burden-bear/Braille-Evalutation-Board/README.md

# Braille-Evalutation-Board
Adapted from https://hackaday.io/project/191181-electromechanical-refreshable-braille-module
