burden-bear/Braille-Evalutation-Board/braille-6/Braille Evaluation Board.kicad_pcb

## KiCad design braille-6/Braille Evaluation Board.kicad_pcb (2025-08-07)

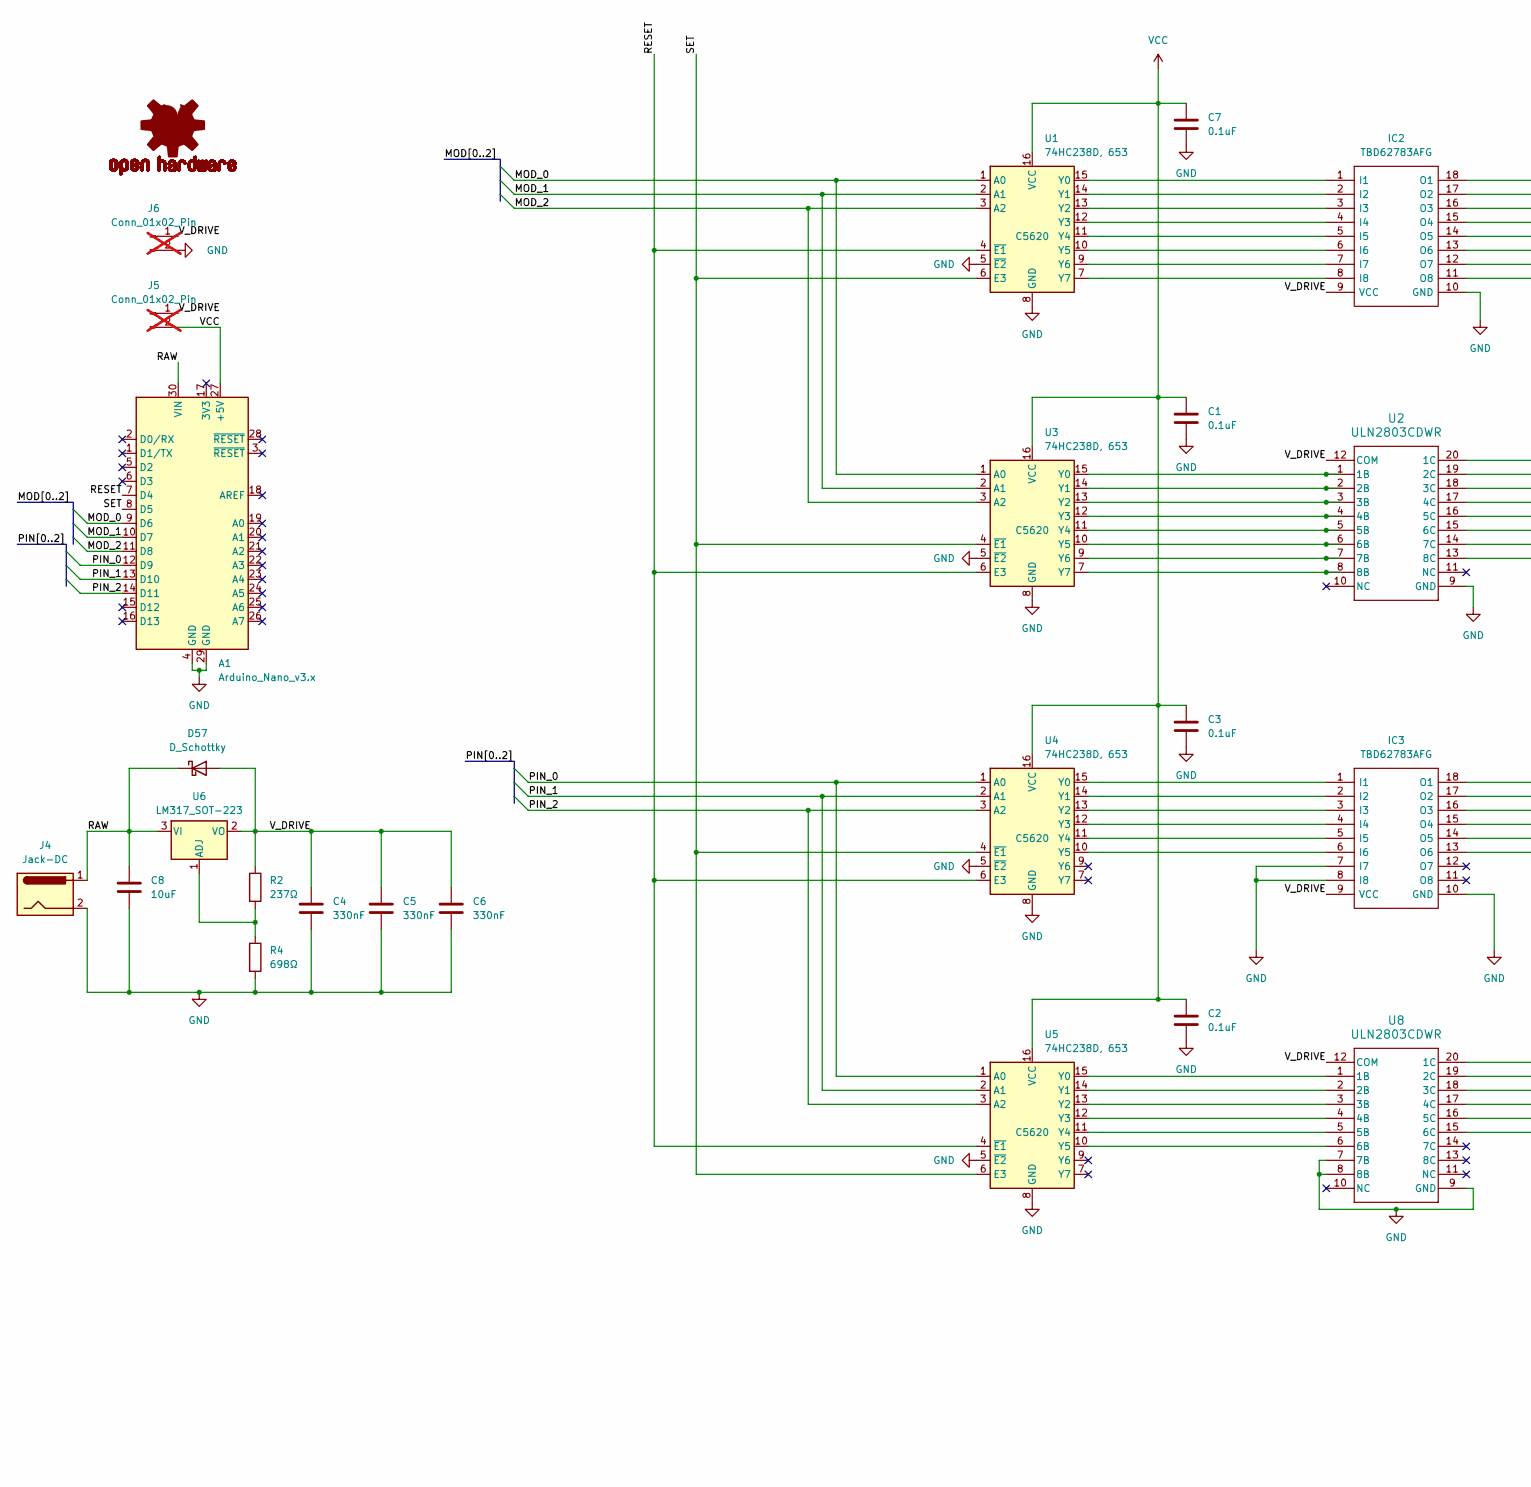
[picture p1: schematic Braille Evaluation Board.kicad_sch, part in row 1, column 1]

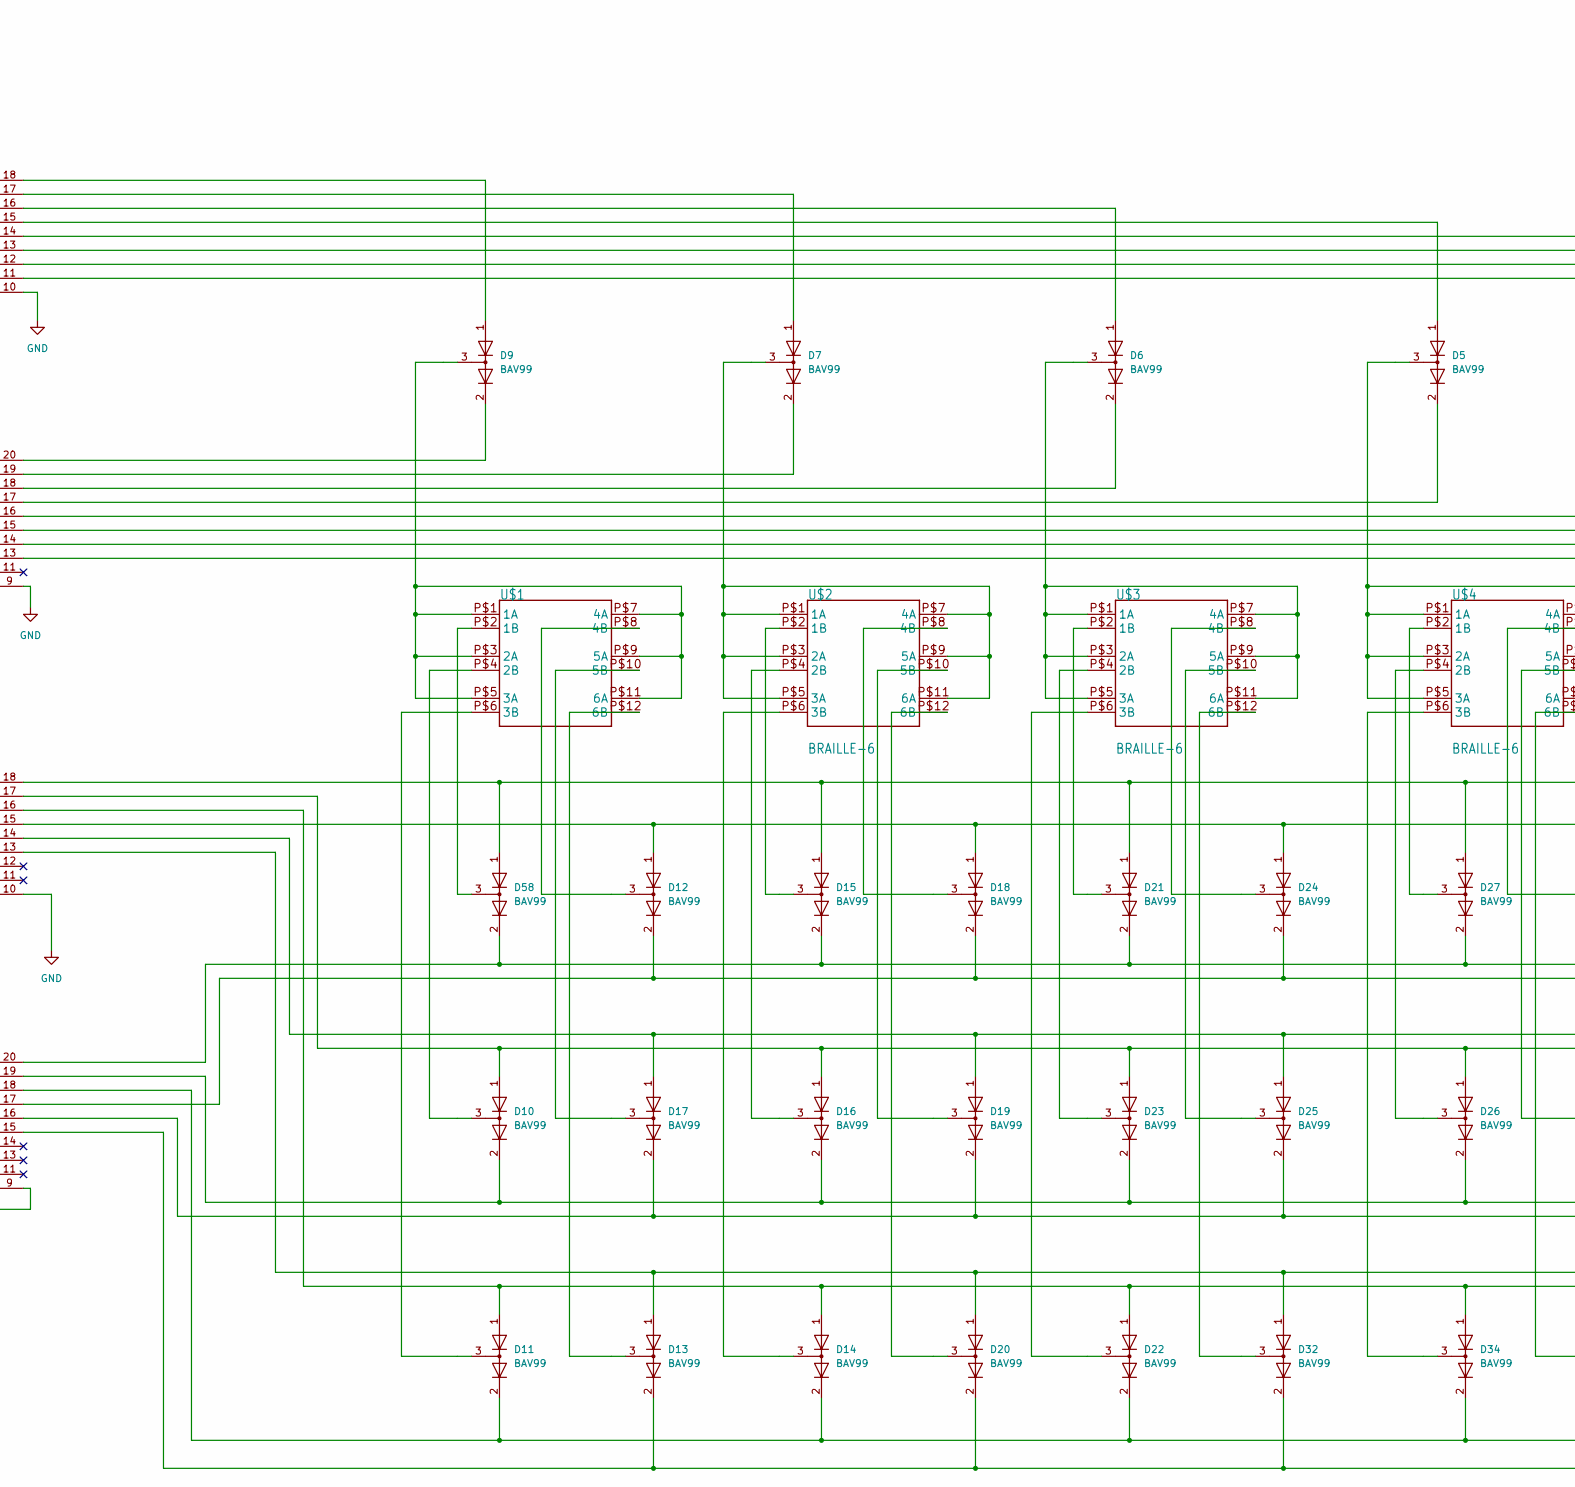
[picture p2: schematic Braille Evaluation Board.kicad_sch, part in row 1, column 2]

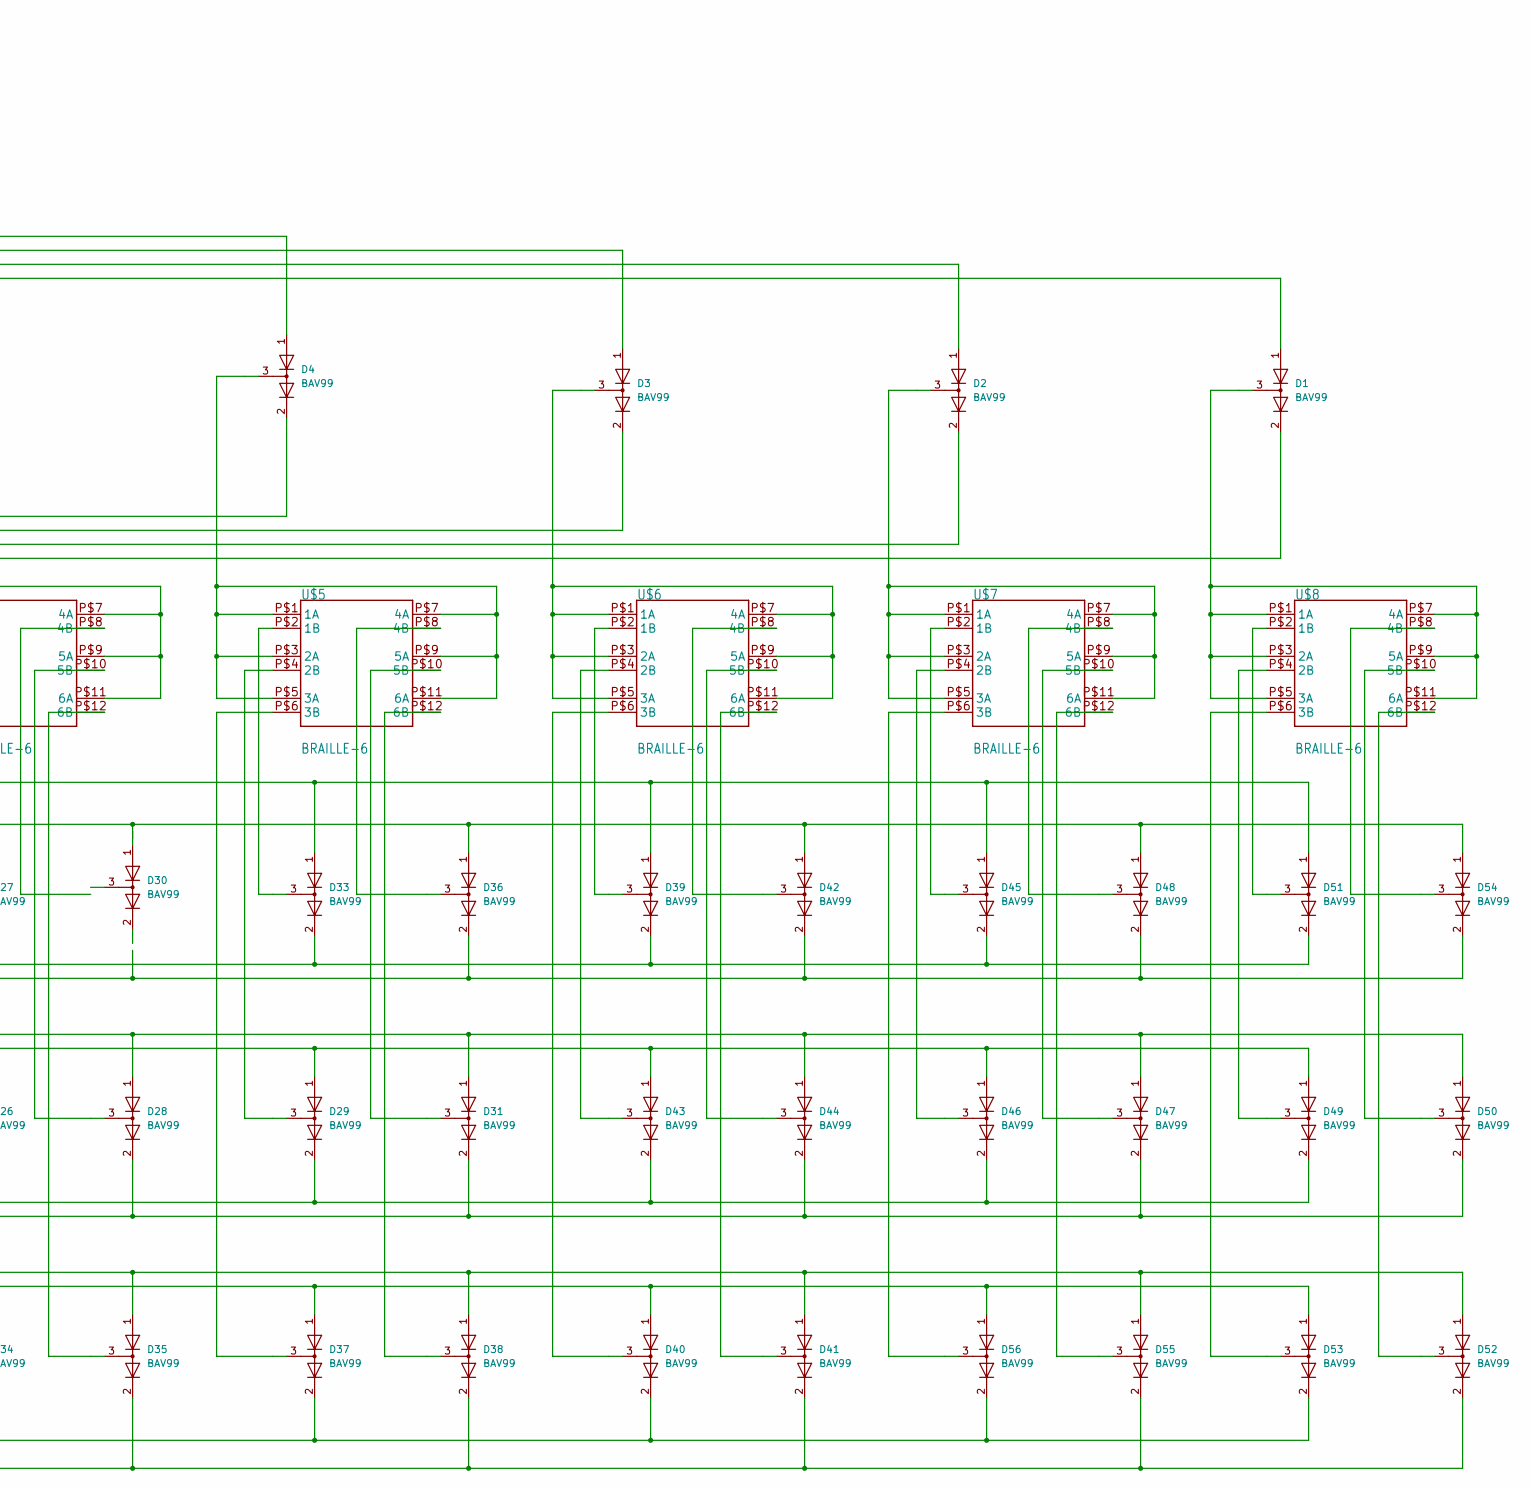
[picture p3: schematic Braille Evaluation Board.kicad_sch, part in row 1, column 3]

Parts:
A1: Arduino_Nano_v3.x; Arduino_Nano
C1, C2, C3, C7: 0.1uF; C_0402_1005Metric; LCSC Part # C71629
C4, C5, C6: 330nF; C_0402_1005Metric; LCSC Part # C913655
C8: 10uF; C_0603_1608Metric; LCSC Part # C92487
D1, D2, D3, D4, D5, D6, D7, D9, D10, D11, D12, D13, D14, D15, D16, D17, D18, D19, D20, D21, D22, D23, D24, D25, D26, D27, D28, D29, D30, D31, D32, D33, D34, D35, D36, D37, D38, D39, D40, D41, D42, D43, D44, D45, D46, D47, D48, D49, D50, D51, D52, D53, D54, D55, D56, D58: BAV99; SOT-23-3; LCSC Part # C7420336
D57: D_Schottky; D_SOD-323; LCSC Part # C177096
IC2, IC3: TBD62783AFG; SOIC-18W_7.5x11.6mm_P1.27mm; Manufacturer_Part_Number TBD62783AFG; Mouser Part Number N/A
J4: Jack-DC; BarrelJack_Kycon_KLDX-0202-xC_Horizontal; LCSC Part # C16214
J5, J6: Conn_01x02_Pin; PinHeader_1x02_P2.54mm_Vertical; not fitted
LOGO1: OSHW-LOGOL-COPPER; OSHW-LOGO-L_COPPER
R2: 237Ω; LED_0603_1608Metric; LCSC Part # C23012
R4: 698Ω; R_0402_1005Metric; LCSC Part # C966739
U1, U3, U4, U5: 74HC238D, 653; SOIC-16_3.9x9.9mm_P1.27mm; LCSC Part # C5620
U2, U8: ULN2803CDWR; DW0020A-MFG; LCSC Part # C7494313
U6: LM317_SOT-223; SOT-223-3_TabPin2; LCSC Part # C51466
U$1, U$2, U$3, U$4, U$5, U$6, U$7, U$8: BRAILLE-6

Connections:
/MOD_0: A1.9 (D6), U1.1 (A0), U3.1 (A0)
/MOD_1: A1.10 (D7), U1.2 (A1), U3.2 (A1)
/MOD_2: A1.11 (D8), U1.3 (A2), U3.3 (A2)
/PIN_0: A1.12 (D9), U4.1 (A0), U5.1 (A0)
/PIN_1: A1.13 (D10), U4.2 (A1), U5.2 (A1)
/PIN_2: A1.14 (D11), U4.3 (A2), U5.3 (A2)
/RAW: A1.30 (VIN), C8.1, D57.1 (K), J4.1, U6.3 (VI)
/RESET: A1.7 (D4), U1.4 (~E1), U3.6 (E3), U4.6 (E3), U5.4 (~E1)
/SET: A1.8 (D5), U1.6 (E3), U3.4 (~E1), U4.4 (~E1), U5.6 (E3)
/V_DRIVE: C4.1, C5.1, C6.1, D57.2 (A), IC2.9 (VCC), IC3.9 (VCC), J5.1, J6.1, R2.1, U2.12 (COM), U6.2 (VO), U8.12 (COM)
GND: A1.4 (GND), A1.29 (GND), C1.2, C2.2, C3.2, C4.2, C5.2, C6.2, C7.2, C8.2, IC2.10 (GND), IC3.7 (I7), IC3.8 (I8), IC3.10 (GND), J4.2, J6.2, R4.2, U1.5 (~E2), U1.8 (GND), U2.9 (GND), U3.5 (~E2), U3.8 (GND), U4.5 (~E2), U4.8 (GND), U5.5 (~E2), U5.8 (GND), U8.7 (7B), U8.8 (8B), U8.9 (GND)
unnamed: D1.2 (A), U2.13 (8C)
unnamed: D2.2 (A), U2.14 (7C)
unnamed: D3.2 (A), U2.15 (6C)
unnamed: D4.2 (A), U2.16 (5C)
unnamed: D5.2 (A), U2.17 (4C)
unnamed: D6.2 (A), U2.18 (3C)
unnamed: D7.2 (A), U2.19 (2C)
unnamed: D9.2 (A), U2.20 (1C)
unnamed: D10.2 (A), D16.2 (A), D23.2 (A), D26.2 (A), D29.2 (A), D43.2 (A), D46.2 (A), D49.2 (A), U8.19 (2C)
unnamed: D11.2 (A), D14.2 (A), D22.2 (A), D34.2 (A), D37.2 (A), D40.2 (A), D53.2 (A), D56.2 (A), U8.18 (3C)
unnamed: D12.2 (A), D18.2 (A), D24.2 (A), D36.2 (A), D42.2 (A), D48.2 (A), D54.2 (A), U8.17 (4C)
unnamed: D13.2 (A), D20.2 (A), D32.2 (A), D35.2 (A), D38.2 (A), D41.2 (A), D52.2 (A), D55.2 (A), U8.15 (6C)
unnamed: D15.2 (A), D21.2 (A), D27.2 (A), D33.2 (A), D39.2 (A), D45.2 (A), D51.2 (A), D58.2 (A), U8.20 (1C)
unnamed: D17.2 (A), D19.2 (A), D25.2 (A), D28.2 (A), D31.2 (A), D44.2 (A), D47.2 (A), D50.2 (A), U8.16 (5C)
unnamed: IC2.1 (I1), U1.15 (Y0)
unnamed: IC2.2 (I2), U1.14 (Y1)
unnamed: IC2.3 (I3), U1.13 (Y2)
unnamed: IC2.4 (I4), U1.12 (Y3)
unnamed: IC2.5 (I5), U1.11 (Y4)
unnamed: IC2.6 (I6), U1.10 (Y5)
unnamed: IC2.7 (I7), U1.9 (Y6)
unnamed: IC2.8 (I8), U1.7 (Y7)
unnamed: D9.1 (K), IC2.18 (O1)
unnamed: D7.1 (K), IC2.17 (O2)
unnamed: D6.1 (K), IC2.16 (O3)
unnamed: D5.1 (K), IC2.15 (O4)
unnamed: D4.1 (K), IC2.14 (O5)
unnamed: D3.1 (K), IC2.13 (O6)
unnamed: D2.1 (K), IC2.12 (O7)
unnamed: D1.1 (K), IC2.11 (O8)
unnamed: IC3.1 (I1), U4.15 (Y0)
unnamed: IC3.2 (I2), U4.14 (Y1)
unnamed: IC3.3 (I3), U4.13 (Y2)
unnamed: IC3.4 (I4), U4.12 (Y3)
unnamed: IC3.5 (I5), U4.11 (Y4)
unnamed: IC3.6 (I6), U4.10 (Y5)
unnamed: D15.1 (K), D21.1 (K), D27.1 (K), D33.1 (K), D39.1 (K), D45.1 (K), D51.1 (K), D58.1 (K), IC3.18 (O1)
unnamed: D10.1 (K), D16.1 (K), D23.1 (K), D26.1 (K), D29.1 (K), D43.1 (K), D46.1 (K), D49.1 (K), IC3.17 (O2)
unnamed: D11.1 (K), D14.1 (K), D22.1 (K), D34.1 (K), D37.1 (K), D40.1 (K), D53.1 (K), D56.1 (K), IC3.16 (O3)
unnamed: D12.1 (K), D18.1 (K), D24.1 (K), D36.1 (K), D42.1 (K), D48.1 (K), D54.1 (K), IC3.15 (O4)
unnamed: D17.1 (K), D19.1 (K), D25.1 (K), D28.1 (K), D31.1 (K), D44.1 (K), D47.1 (K), D50.1 (K), IC3.14 (O5)
unnamed: D13.1 (K), D20.1 (K), D32.1 (K), D35.1 (K), D38.1 (K), D41.1 (K), D52.1 (K), D55.1 (K), IC3.13 (O6)
unnamed: U2.1 (1B), U3.15 (Y0)
unnamed: U2.2 (2B), U3.14 (Y1)
unnamed: U2.3 (3B), U3.13 (Y2)
unnamed: U2.4 (4B), U3.12 (Y3)
unnamed: U2.5 (5B), U3.11 (Y4)
unnamed: U2.6 (6B), U3.10 (Y5)
unnamed: U2.7 (7B), U3.9 (Y6)
unnamed: U2.8 (8B), U3.7 (Y7)
unnamed: U5.15 (Y0), U8.1 (1B)
unnamed: U5.14 (Y1), U8.2 (2B)
unnamed: U5.13 (Y2), U8.3 (3B)
unnamed: U5.12 (Y3), U8.4 (4B)
unnamed: U5.11 (Y4), U8.5 (5B)
unnamed: U5.10 (Y5), U8.6 (6B)
unnamed: R2.2, R4.1, U6.1 (ADJ)
unnamed: D9.3 (K), U$1.P$1 (1A), U$1.P$3 (2A), U$1.P$5 (3A), U$1.P$7 (4A), U$1.P$9 (5A), U$1.P$11 (6A)
unnamed: D58.3 (K), U$1.P$2 (1B)
unnamed: D10.3 (K), U$1.P$4 (2B)
unnamed: D11.3 (K), U$1.P$6 (3B)
unnamed: D12.3 (K), U$1.P$8 (4B)
unnamed: D17.3 (K), U$1.P$10 (5B)
unnamed: D13.3 (K), U$1.P$12 (6B)
unnamed: D7.3 (K), U$2.P$1 (1A), U$2.P$3 (2A), U$2.P$5 (3A), U$2.P$7 (4A), U$2.P$9 (5A), U$2.P$11 (6A)
unnamed: D15.3 (K), U$2.P$2 (1B)
unnamed: D16.3 (K), U$2.P$4 (2B)
unnamed: D14.3 (K), U$2.P$6 (3B)
unnamed: D18.3 (K), U$2.P$8 (4B)
unnamed: D19.3 (K), U$2.P$10 (5B)
unnamed: D20.3 (K), U$2.P$12 (6B)
unnamed: D6.3 (K), U$3.P$1 (1A), U$3.P$3 (2A), U$3.P$5 (3A), U$3.P$7 (4A), U$3.P$9 (5A), U$3.P$11 (6A)
unnamed: D21.3 (K), U$3.P$2 (1B)
unnamed: D23.3 (K), U$3.P$4 (2B)
unnamed: D22.3 (K), U$3.P$6 (3B)
unnamed: D24.3 (K), U$3.P$8 (4B)
unnamed: D25.3 (K), U$3.P$10 (5B)
unnamed: D32.3 (K), U$3.P$12 (6B)
unnamed: D5.3 (K), U$4.P$1 (1A), U$4.P$3 (2A), U$4.P$5 (3A), U$4.P$7 (4A), U$4.P$9 (5A), U$4.P$11 (6A)
unnamed: D27.3 (K), U$4.P$2 (1B)
unnamed: D26.3 (K), U$4.P$4 (2B)
unnamed: D34.3 (K), U$4.P$6 (3B)
unnamed: D28.3 (K), U$4.P$10 (5B)
unnamed: D35.3 (K), U$4.P$12 (6B)
unnamed: D4.3 (K), U$5.P$1 (1A), U$5.P$3 (2A), U$5.P$5 (3A), U$5.P$7 (4A), U$5.P$9 (5A), U$5.P$11 (6A)
unnamed: D33.3 (K), U$5.P$2 (1B)
unnamed: D29.3 (K), U$5.P$4 (2B)
unnamed: D37.3 (K), U$5.P$6 (3B)
unnamed: D36.3 (K), U$5.P$8 (4B)
unnamed: D31.3 (K), U$5.P$10 (5B)
unnamed: D38.3 (K), U$5.P$12 (6B)
unnamed: D3.3 (K), U$6.P$1 (1A), U$6.P$3 (2A), U$6.P$5 (3A), U$6.P$7 (4A), U$6.P$9 (5A), U$6.P$11 (6A)
unnamed: D39.3 (K), U$6.P$2 (1B)
unnamed: D43.3 (K), U$6.P$4 (2B)
unnamed: D40.3 (K), U$6.P$6 (3B)
unnamed: D42.3 (K), U$6.P$8 (4B)
unnamed: D44.3 (K), U$6.P$10 (5B)
unnamed: D41.3 (K), U$6.P$12 (6B)
unnamed: D2.3 (K), U$7.P$1 (1A), U$7.P$3 (2A), U$7.P$5 (3A), U$7.P$7 (4A), U$7.P$9 (5A), U$7.P$11 (6A)
unnamed: D45.3 (K), U$7.P$2 (1B)
unnamed: D46.3 (K), U$7.P$4 (2B)
unnamed: D56.3 (K), U$7.P$6 (3B)
unnamed: D48.3 (K), U$7.P$8 (4B)
unnamed: D47.3 (K), U$7.P$10 (5B)
unnamed: D55.3 (K), U$7.P$12 (6B)
unnamed: D1.3 (K), U$8.P$1 (1A), U$8.P$3 (2A), U$8.P$5 (3A), U$8.P$7 (4A), U$8.P$9 (5A), U$8.P$11 (6A)
unnamed: D51.3 (K), U$8.P$2 (1B)
unnamed: D49.3 (K), U$8.P$4 (2B)
unnamed: D53.3 (K), U$8.P$6 (3B)
unnamed: D54.3 (K), U$8.P$8 (4B)
unnamed: D50.3 (K), U$8.P$10 (5B)
unnamed: D52.3 (K), U$8.P$12 (6B)
VCC: A1.27 (+5V), C1.1, C2.1, C3.1, C7.1, J5.2, U1.16 (VCC), U3.16 (VCC), U4.16 (VCC), U5.16 (VCC)

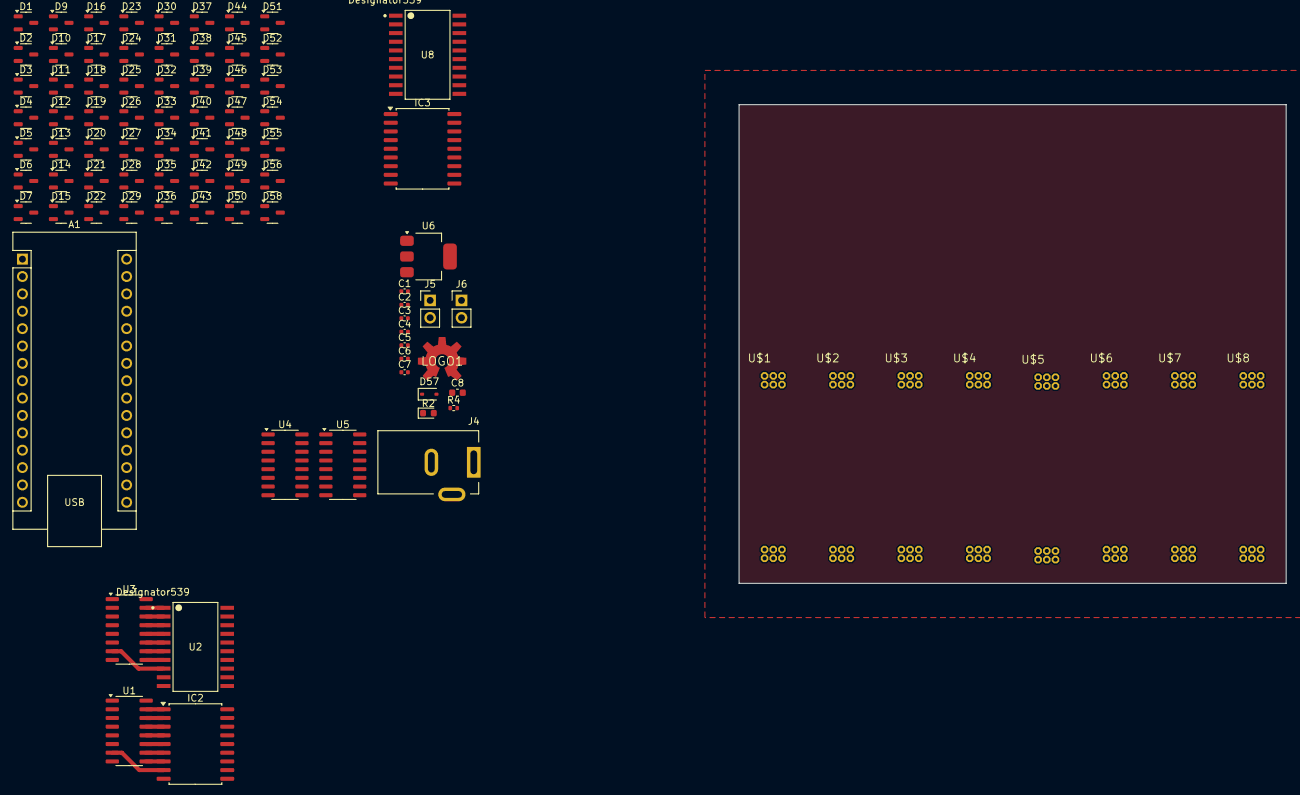
[picture p4: board Braille Evaluation Board.kicad_pcb from above]

Board: 4 copper layers, 80.0 x 70.0 mm, 89 parts (0 on the bottom side), 124 nets.
